MykolaBohomaz/MiniOscilloscope/prebuilt/README.txt

Firmware built from the sources in this repo on 2026-10-02 (v0.1.0).
Default LCD contrast 12.0 V; adjust live with: tools/scope.py contrast

10cb06967929252349182e1c9a0f2656  scope.bin
