MykolaBohomaz/MiniOscilloscope/docs/img/screen_clip_tri.png

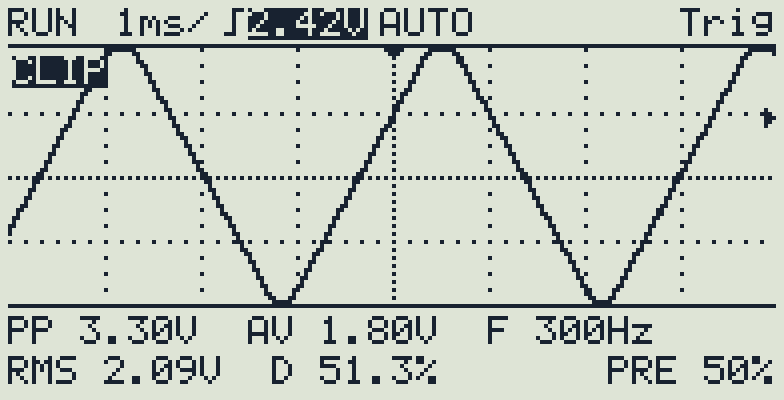
docs/img/screen_clip_tri.png
