MykolaBohomaz/MiniOscilloscope/docs/img/screen_sine_1k.png

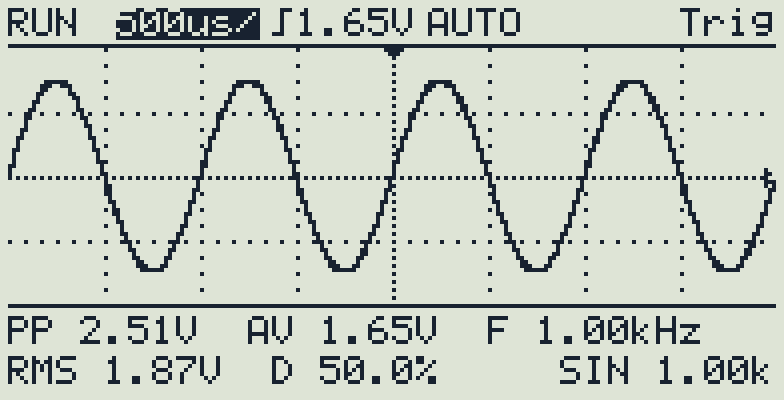
docs/img/screen_sine_1k.png
