MykolaBohomaz/MiniOscilloscope/docs/img/screen_square_10k.png

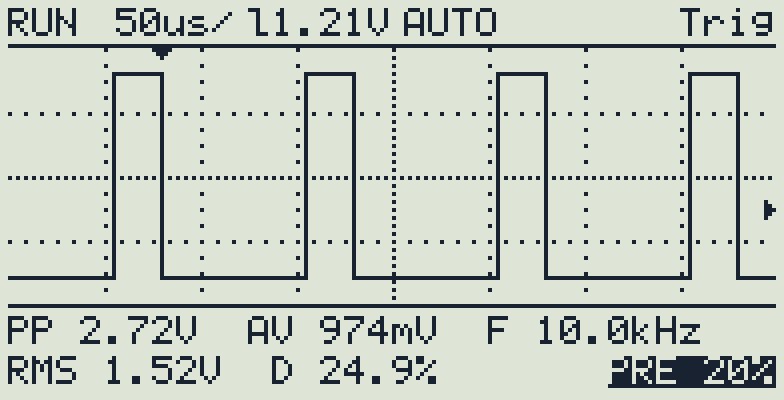
docs/img/screen_square_10k.png
